MeCoolGJK/GJK_WC_counter/STL_FILES/SR04+05_cover/SR05_COVER_V2.1.stl

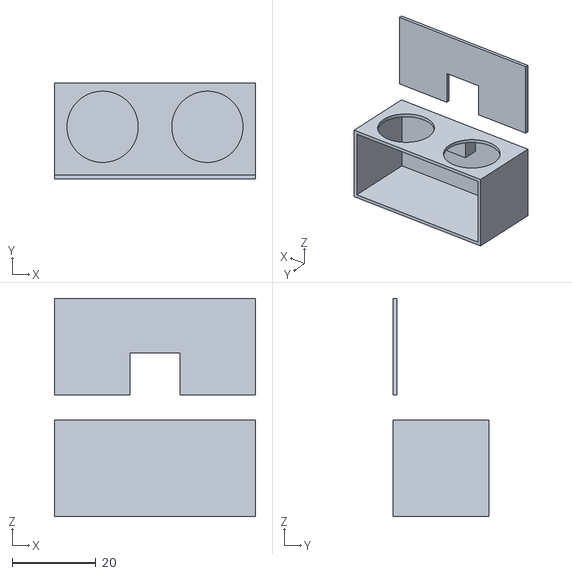
[picture p2: CAD file, 2021-04-02]
STL_FILES/SR04+05_cover/SR05_COVER_V2.1.stl
48.0 x 23.0 x 52.0
