MeCoolGJK/GJK_WC_counter/STL_FILES/SR04+05_cover/PATKA_pruchozi v1.stl

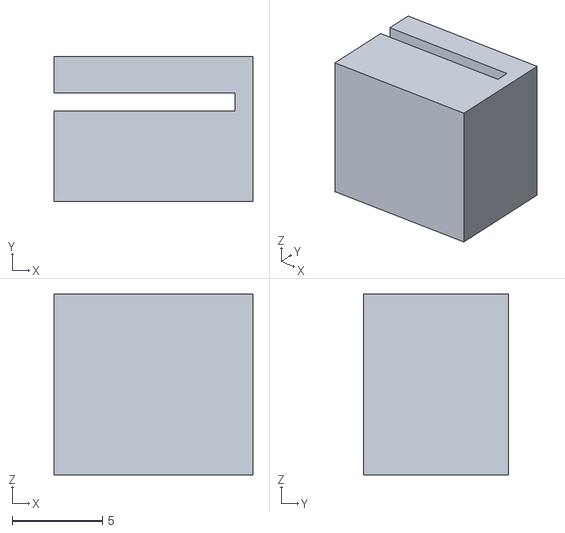
[picture p3: CAD file, 2021-04-02]
STL_FILES/SR04+05_cover/PATKA_pruchozi v1.stl
11.0 x 8.00 x 10.0
