MeCoolGJK/GJK_WC_counter/(list of files, cad)

Other CAD files:
STL_FILES/SR04+05_cover/SR04_COVER_V2.1.stl
STL_FILES/SR04+05_cover/SR04_COVER_V2.stl
STL_FILES/SR04+05_cover/SR05_COVER_V2.stl
