MeCoolGJK/GJK_WC_counter/SCHEMATICS/ESP32+LVL+USM_DPS.pdf

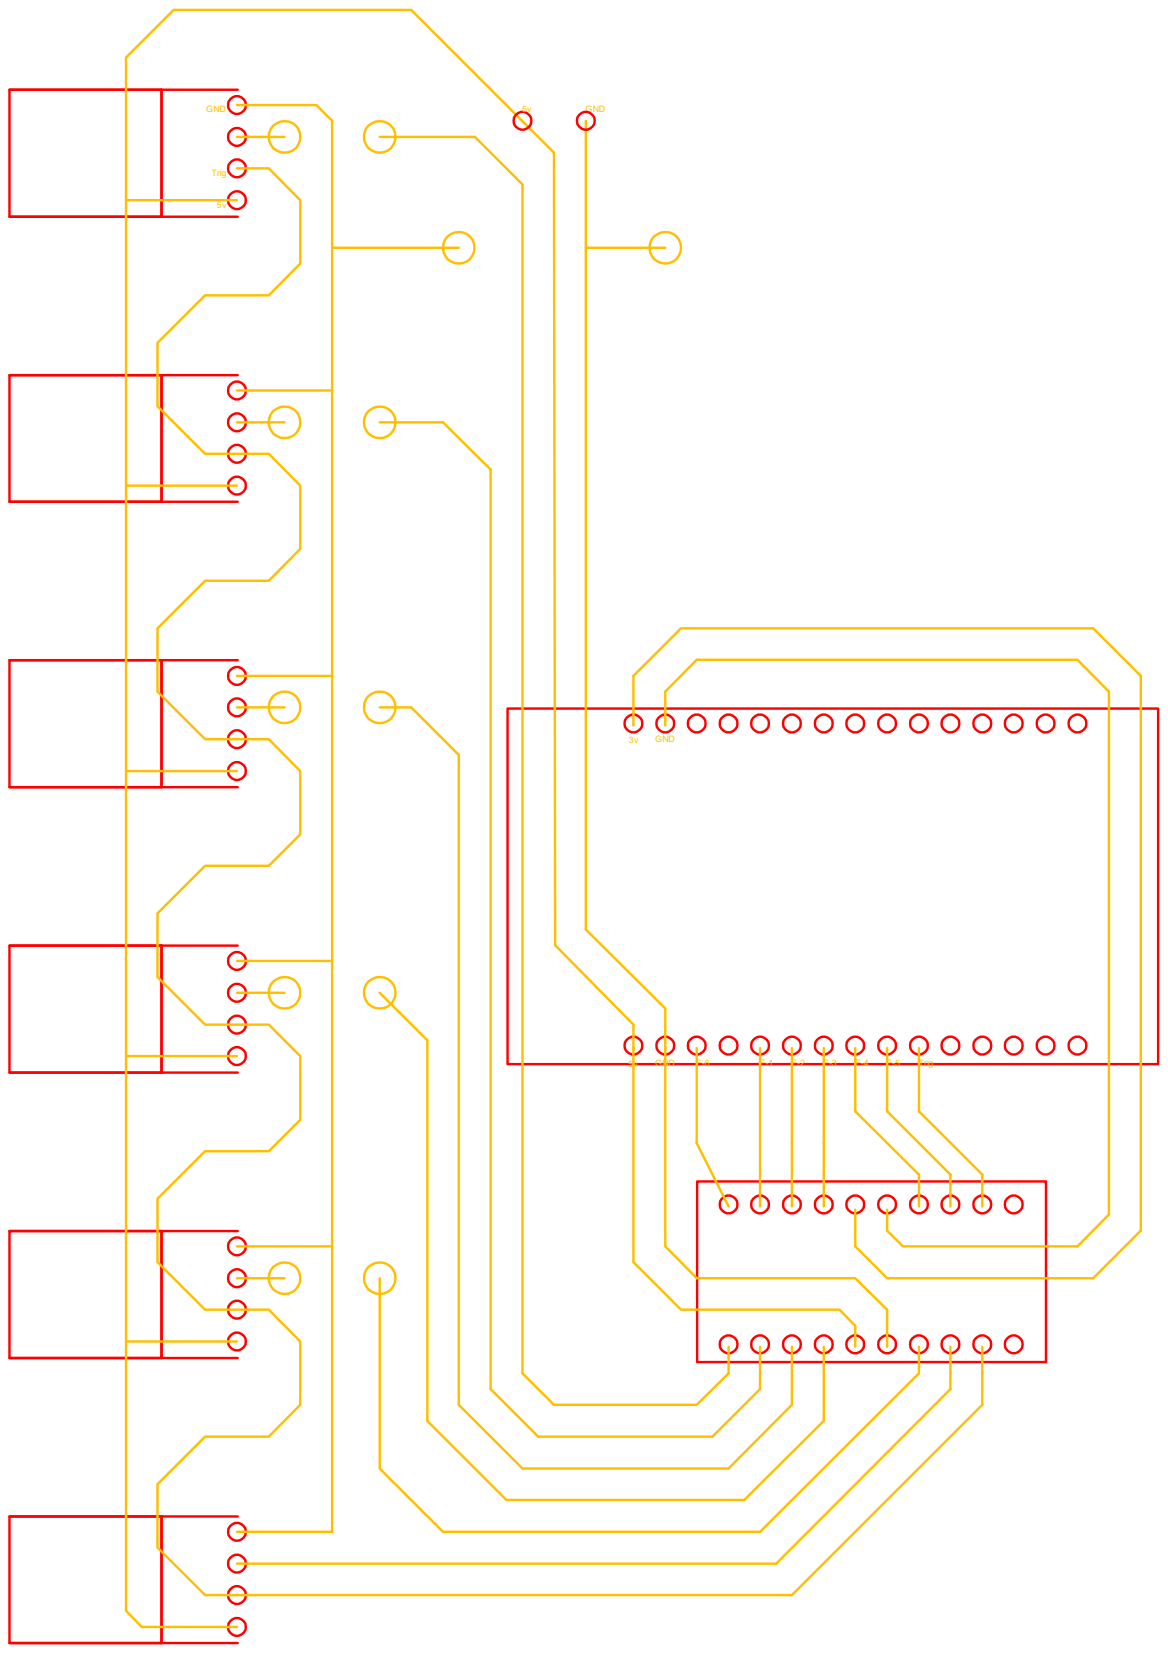
[picture p4: page 1]
GND; Trig E-6; Trig
