MeCoolGJK/GJK_WC_counter/SCHEMATICS/ESP32_6x-USM_MQTT-NODE-RED_v0.2.pdf

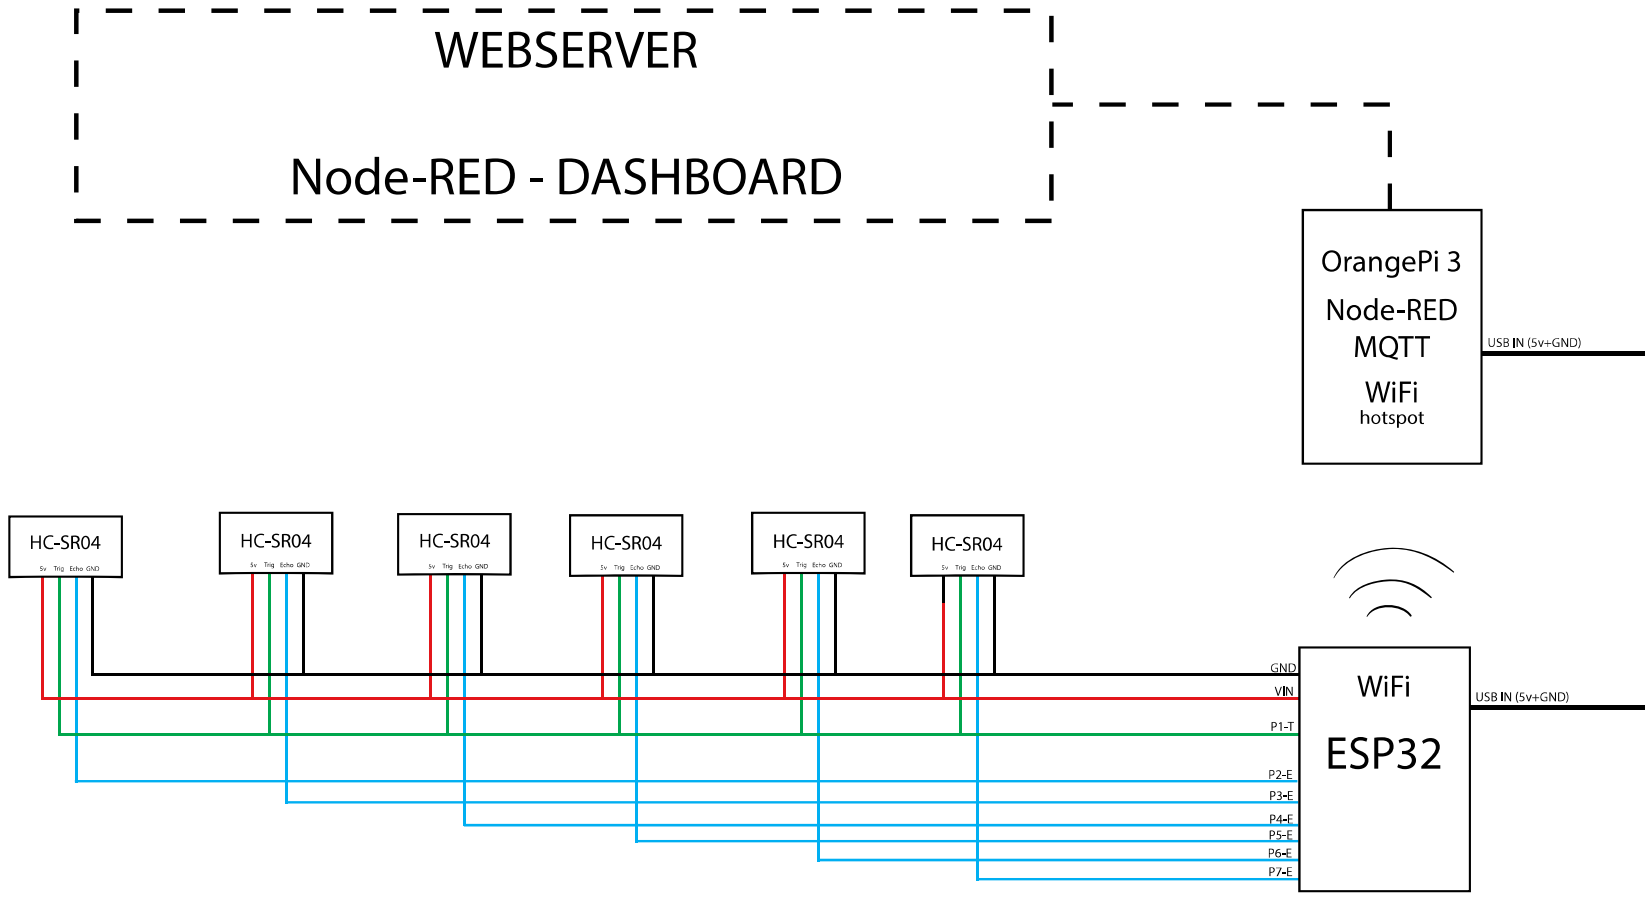
[picture p5: page 1]
