MeCoolGJK/GJK_WC_counter/TESTING_CODES/ARD_TEST/ARD_TEST.ino

int led1 = 13;
int led2 = 12;

void setup() {
  // put your setup code here, to run once:
  pinMode(led1, OUTPUT);
  pinMode(led2, OUTPUT);
}

void loop() {
  // put your main code here, to run repeatedly:
digitalWrite(led1, HIGH);
digitalWrite(led2, HIGH);
delay(200);

}
