MeCoolGJK/GJK_WC_counter/(commit log)

2021-01-31 ESP32_USM_MQTT_NODE-RED
    Implementation of MQTT, NODE-RED and NODE-RED dashboard
2021-01-31 ESP32_USM_MQTT_NODE-RED_patch
    Added missing character.
    [ESP32_USM_MQTT_NODE-RED.ino]
2021-03-16 Changes to be committed: new file: DEVELOPING_CODES/ESP32_USM_MQTT_NODE-RED/ESP32_USM_MQTT_NODE-RED.ino new file: FINAL_CODE/PRESENTATION/ESP32_6xUSM_MQTT_NODE-RED_ARMBIAN_PRESENTATION/ESP32_6xUSM_MQ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
2021-03-16 Changes to be committed: deleted: ARD_LCD_2xUSM_beta/ARD_LCD_2xUSM_beta.ino deleted: ARD_LCD_USM_beta/ARD_LCD_USM_beta.ino deleted: ARD_TEST/ARD_TEST.ino deleted: ESP32_USM_MQTT_NODE-RED/ESP32_USM_MQ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
2021-03-16 Changes to be committed: modified: FINAL_CODE/USAGE/ESP32_6xUSM_MQTT_NODE-RED_ARMBIAN_/ESP32_6xUSM_MQTT_NODE-RED_ARMBIAN_.ino
2021-04-02 Added STL files
    [PATKA_pruchozi v1.stl, SR04_COVER_V2.1.stl, SR04_COVER_V2.stl, SR05_COVER_V2.1.stl, SR05_COVER_V2.stl]
2021-04-05 Added schematics
